goshawk22/wspr-balloon-tracker/hardware/v2/SCH_Schematic3_1-P1_2025-12-21.png

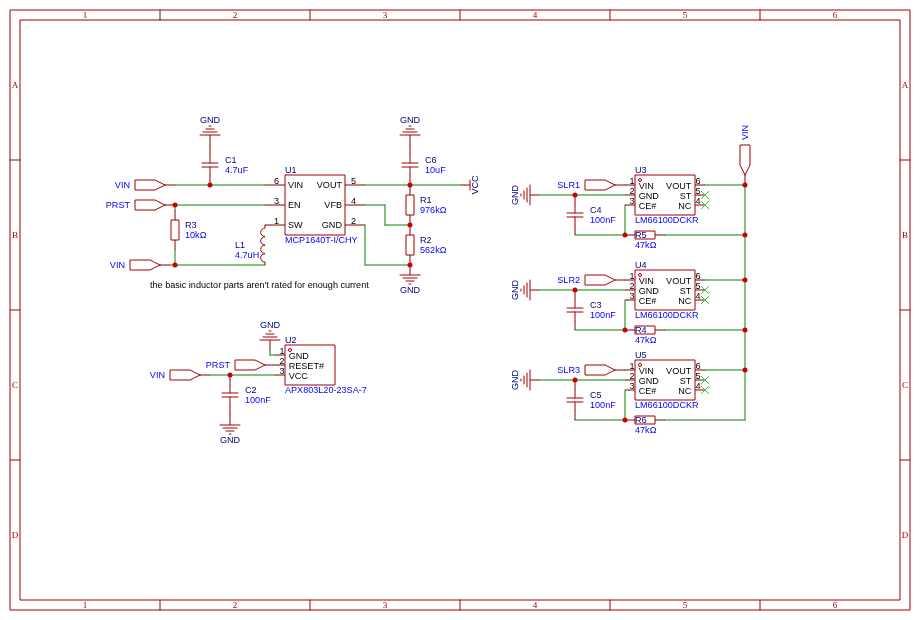
hardware/v2/SCH_Schematic3_1-P1_2025-12-21.png
