goshawk22/wspr-balloon-tracker/hardware/v2/SCH_Schematic3_2025-12-21.pdf

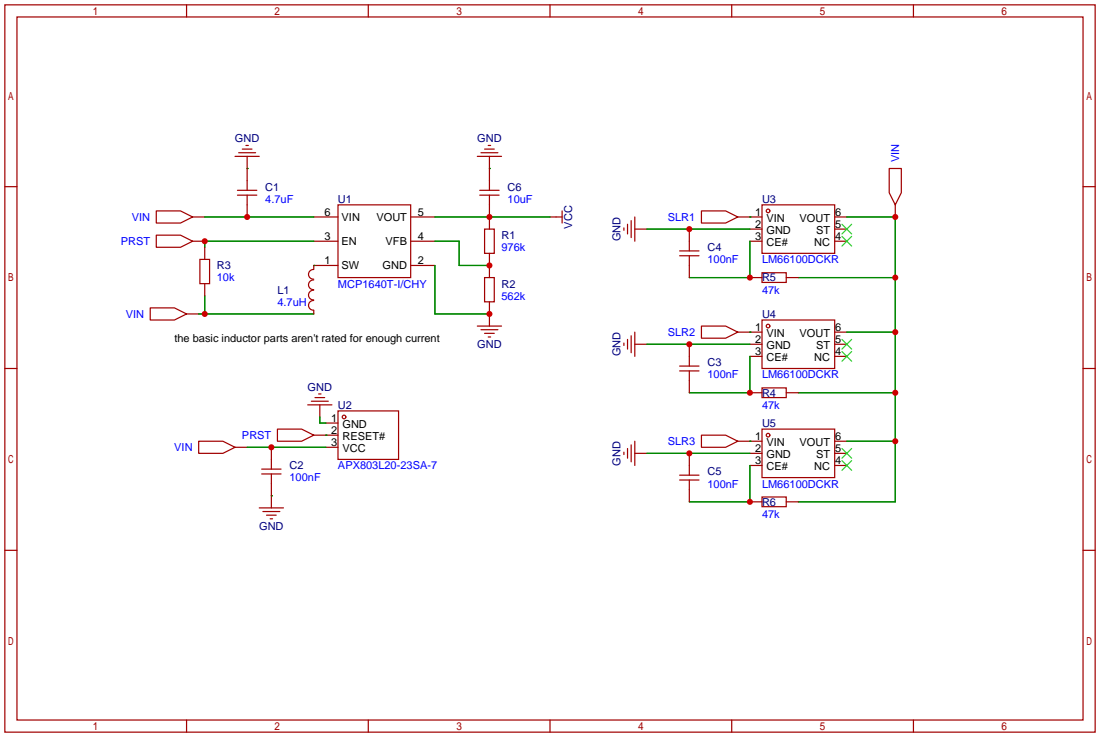
[picture p8: page 1]

the basic inductor parts aren't rated for enough current
