goshawk22/wspr-balloon-tracker/hardware/v2/SCH_Schematic1_2025-12-21.pdf

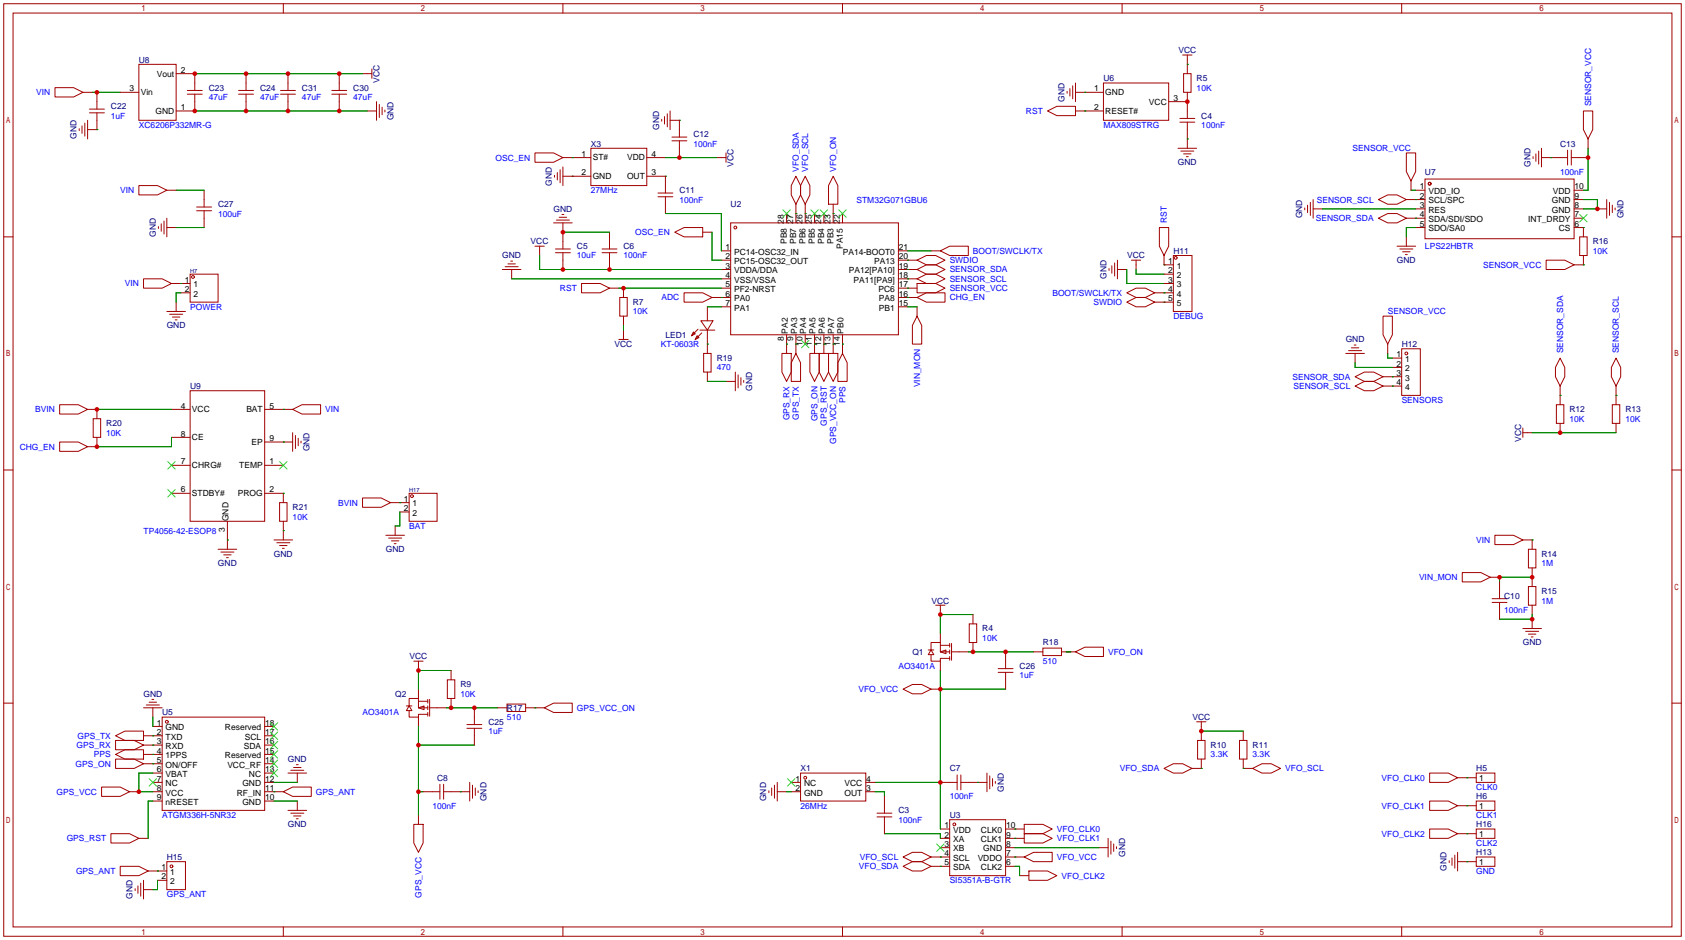
[picture p9: page 1]
