goshawk22/wspr-balloon-tracker/hardware/v1/SCH_Schematic1_2025-08-19.pdf

## VCCVIN

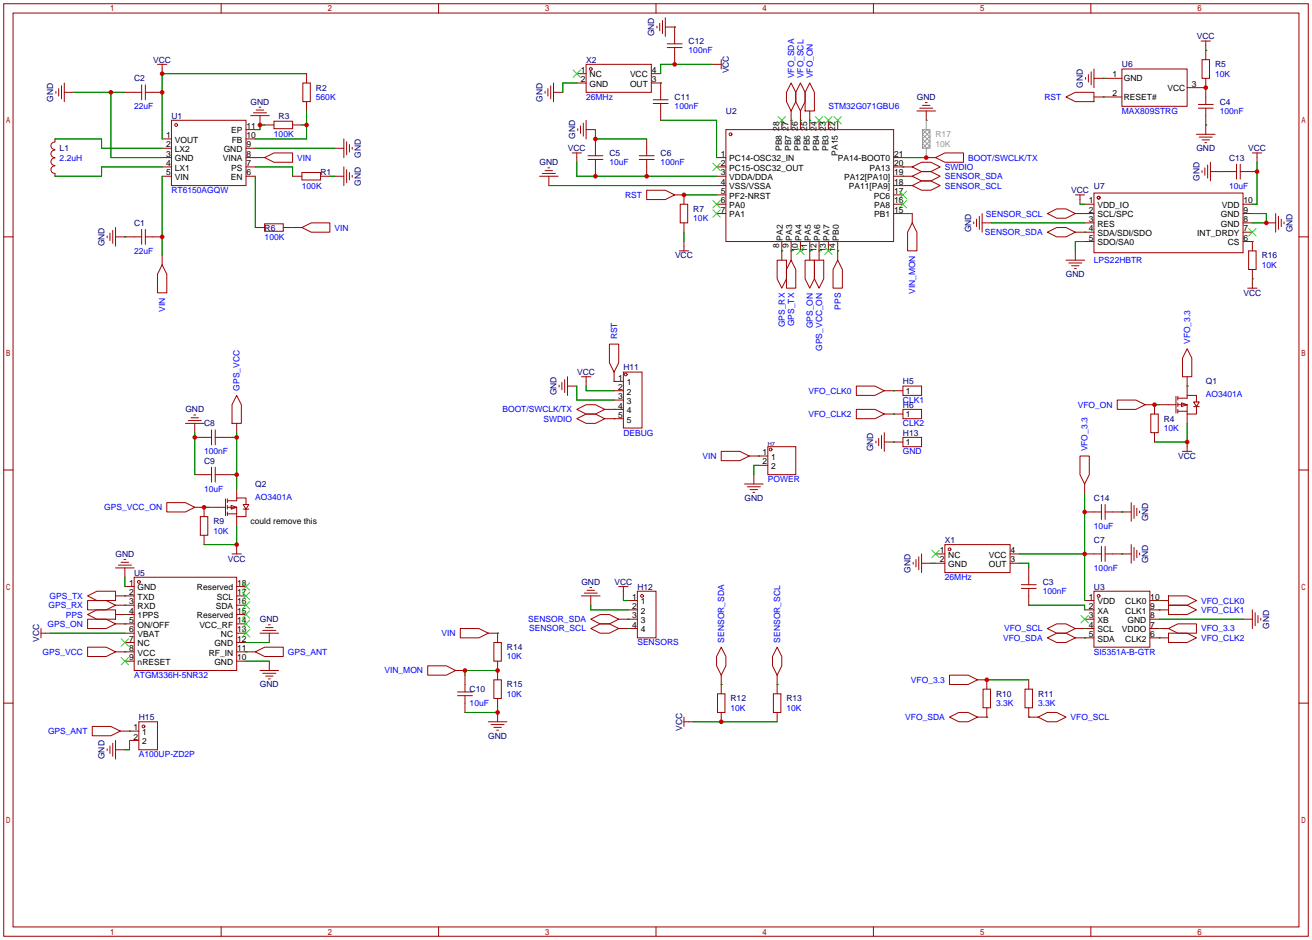
[picture p10: page 1]
