goshawk22/wspr-balloon-tracker/(list of files, drawings)

Other design files:
hardware/v1/ProPrj_picoballoon-tracker_2025-08-19.epro
hardware/v2/ProPrj_picoballoon-tracker-v2_2025-12-21.epro
