goshawk22/wspr-balloon-tracker/src/sensors.h

#ifndef SENSORS_H
#define SENSORS_H

#include "config.h"
#include "console.h"
#include "stm32yyxx_ll_adc.h"
#include "Arduino.h"
#include <Wire.h>
#include <Adafruit_LPS2X.h>
#include <Adafruit_Sensor.h>

class Sensors
{
public:
    Sensors();
    void begin();
    void update();
    void setSensorVCC(bool enabled);

    // Accessors
    float getVoltage() const
    {
        return voltage;
    }
    float getIntTemperature() const
    {
        return int_temperature;
    }
    float getTemperature() const
    {
        return temperature;
    }
    float getPressure() const
    {
        return pressure;
    }

private:
    float voltage; // Voltage read from ADC
    float int_temperature; // Temperature read from internal sensor
    float temperature; // Temperature read from LPS22 sensor
    float pressure; // Pressure read from LPS22 sensor

    static constexpr uint32_t TS_CAL1_ADDR = 0x1FFF75A8; // Temp calibration @ 30°C
    static constexpr uint32_t TS_CAL2_ADDR = 0x1FFF75CA; // Temp calibration @ 130°C
    static constexpr float TEMP30_CAL_TEMP = 30.0f;
    static constexpr float TEMP130_CAL_TEMP = 130.0f;

    static uint32_t readVref();
    static int32_t readVoltage(int32_t VRef, uint32_t pin);
};

#endif
