goshawk22/wspr-balloon-tracker/variants/pico_tracker/variant_PICO_TRACKER.cpp

/*
 *******************************************************************************
 * Copyright (c) 2020, STMicroelectronics
 * All rights reserved.
 *
 * This software component is licensed by ST under BSD 3-Clause license,
 * the "License"; You may not use this file except in compliance with the
 * License. You may obtain a copy of the License at:
 *                        opensource.org/licenses/BSD-3-Clause
 *
 *******************************************************************************
 */
#if defined(ARDUINO_PICO_TRACKER)
#include "pins_arduino.h"

// Digital PinName array
const PinName digitalPin[] = {
  PA_0,   // D0/A0
  PA_1,   // D1/A1
  PA_2,   // D2/A2
  PA_3,   // D3/A3
  PA_4,   // D4/A4
  PA_5,   // D5/A5
  PA_6,   // D6/A6
  PA_7,   // D7/A7
  PA_8,   // D8
  PA_11,  // D9
  PA_12,  // D10
  PA_13,  // D11
  PA_14,  // D12
  PA_15,  // D13
  PB_0,   // D14/A8
  PB_1,   // D15/A9
  PB_3,   // D16
  PB_4,   // D17
  PB_5,   // D18
  PB_6,   // D19
  PB_7,   // D20
  PB_8,   // D21
  PC_6,   // D22
  PC_14,  // D23
  PC_15,  // D24
  PF_2,   // D25
  PA_9_R, // D26
  PA_10_R // D27
};

// Analog (Ax) pin number array
const uint32_t analogInputPin[] = {
  0,  // A0,  PA0
  1,  // A1,  PA1
  2,  // A2,  PA2
  3,  // A3,  PA3
  4,  // A4,  PA4
  5,  // A5,  PA5
  6,  // A6,  PA6
  7,  // A7,  PA7
  14, // A8,  PB0
  15  // A9,  PB1
};

// ----------------------------------------------------------------------------
#ifdef __cplusplus
extern "C" {
#endif

/**
  * @brief  System Clock Configuration
  * @param  None
  * @retval None
  */
 // for LPUART, clock must be in the range [3x baud rate..4096 x baud rate], so max clock is 9600 * 4096 = 39321600
 // currently we use 18 MHz
void SystemClock_Config(void)
{
  RCC_OscInitTypeDef RCC_OscInitStruct = {0};
  RCC_ClkInitTypeDef RCC_ClkInitStruct = {0};

  /** Configure the main internal regulator output voltage
  */
  HAL_PWREx_ControlVoltageScaling(PWR_REGULATOR_VOLTAGE_SCALE1);

  /** Initializes the RCC Oscillators according to the specified parameters
  * in the RCC_OscInitTypeDef structure.
  */
  RCC_OscInitStruct.OscillatorType = RCC_OSCILLATORTYPE_HSE;
  RCC_OscInitStruct.HSEState = RCC_HSE_BYPASS;
  RCC_OscInitStruct.HSIDiv = RCC_HSI_DIV1;
  RCC_OscInitStruct.HSICalibrationValue = RCC_HSICALIBRATION_DEFAULT;
  RCC_OscInitStruct.PLL.PLLState = RCC_PLL_ON;
  RCC_OscInitStruct.PLL.PLLSource = RCC_PLLSOURCE_HSE;
  RCC_OscInitStruct.PLL.PLLM = RCC_PLLM_DIV2;
  RCC_OscInitStruct.PLL.PLLN = 8;
  RCC_OscInitStruct.PLL.PLLP = RCC_PLLP_DIV2;
  RCC_OscInitStruct.PLL.PLLQ = RCC_PLLQ_DIV2;
  RCC_OscInitStruct.PLL.PLLR = RCC_PLLR_DIV6;
  if (HAL_RCC_OscConfig(&RCC_OscInitStruct) != HAL_OK)
  {
    Error_Handler();
  }

  /** Initializes the CPU, AHB and APB buses clocks
  */
  RCC_ClkInitStruct.ClockType = RCC_CLOCKTYPE_HCLK|RCC_CLOCKTYPE_SYSCLK
                              |RCC_CLOCKTYPE_PCLK1;
  RCC_ClkInitStruct.SYSCLKSource = RCC_SYSCLKSOURCE_PLLCLK;
  RCC_ClkInitStruct.AHBCLKDivider = RCC_SYSCLK_DIV1;
  RCC_ClkInitStruct.APB1CLKDivider = RCC_HCLK_DIV1;

  if (HAL_RCC_ClockConfig(&RCC_ClkInitStruct, FLASH_LATENCY_0) != HAL_OK)
  {
    Error_Handler();
  }
  // Update SystemCoreClock global variable
  SystemCoreClockUpdate();
}

#ifdef __cplusplus
}
#endif
#endif /* ARDUINO_PICO_TRACKER */
