goshawk22/wspr-balloon-tracker/src/telemetry.h

#ifndef TELEMETRY_H
#define TELEMETRY_H

#include <WsprEncoded.h>
#include <si5351.h>
#include <JTEncode.h>
#include <rs_common.h>
#include <int.h>
#include <string.h>
#include <Wire.h>
#include "config.h"
#include "console.h"
#include "led.h"

class Telemetry
{
public:
    Telemetry(Si5351 &si5351);
    void init();
    void sendType1(char call[], char loc[], uint8_t dbm);
    void sendBasic(char loc[], int32_t altitudeMeters, int8_t temperatureCelsius, double voltageVolts, uint8_t speedKnots);
    void sendExtended(char loc[], uint8_t satellites, uint32_t fix_time);
    void sendSlot1_new(char loc[], double voltageVolts);
    void sendSlot2_new(int32_t altitudeMeters, uint8_t speedKPH, int8_t temperatureCelsius, uint8_t satellites);
    uint32_t getFrequency() const
    {
        return cd.freq;
    }
    uint8_t getMinute() const
    {
        return cd.min;
    }
    bool isTransmitting() const {
        return transmitting;
    }
    bool isExtendedSent() const {
        return sentExtended;
    }
    void setExtendedSent(bool value) {
        sentExtended = value;
    }
private:
    void tx(unsigned long freq);
    void set_tx_buffer(const char* call, const char* loc, uint8_t dbm);
    Si5351 si5351;
    JTEncode jtencode;
    uint8_t tx_buffer[255];
    WsprChannelMap::ChannelDetails cd;

    HardwareTimer *timer;
    volatile bool transmitting;
    volatile uint8_t current_symbol;
    volatile unsigned long base_freq;

    bool sentExtended = false; // Flag to indicate if extended telemetry has been sent

    // Timer callback function (must be static)
    static void timerCallback();
    static Telemetry* instance; // For callback access
};

#endif
