goshawk22/wspr-balloon-tracker/(commit log)

2025-07-26 Initial commit Kind of works, transmits Type 1 messages followed by basic telemetry TODO: - Check temperature sensor - Check GPS speed/sats not reporting correctly - Check VIN_MON and that it works f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
    [config.h, console.h, generic_clock.c, gps.cpp, gps.h, main.cpp]
2025-07-27 Fix adc for temp and vin voltage
    [config.h, sensors.cpp]
2025-07-27 Only update sensors before sending and turn GPS off while sending
    Ensures we don't use too much current while transmitting
    [main.cpp]
2025-07-27 Use USART1 for pc serial
    SS just wasn't working and causing all sorts of issues.
    Annoying since we now have to use USART1 on the sensor I2C bus and obviously can't use both at the same time.
    Will have to see if we can get LPUART1 working for GPS.
    [console.h, main.cpp]
2025-07-27 Use hardware timer for WSPR
    Now we're ready to add watchdog.
2025-07-27 Fix LPUART
    Turns out our clock speed was too high
    Drop it to 18MHz, which should be plenty and save some power too.
    Now we can use sensors again!
    [config.h, console.h, gps.cpp, main.cpp, variant_PICO_TRACKER.cpp]
2025-07-30 Add extended telemetry
    Currently we transmit pressure, 8 figure maidenhead grid, uptime and sats
2025-07-30 Pass 6 figure grid to JTEncode
    Doesn't support 8 figure
    [telemetry.cpp]
2025-07-30 Add watchdog timer
    Didn't crash without it while running for about 8h or so before adding the watchdog so it's probably stable.
    Add the watchdog in case something weird happens.
    16s is just a random number I cam up with
    [main.cpp]
2025-07-30 Configure PPS pin
2025-08-07 Improve power on in low power conditions
    Maiden flight failed to wake up the following morning
    Testing overnight on the ground revealed that it entered a reset loop, where the MCU would crash after powering on the SI5351, likely due to inrush current. The MCU was the reset by the watchdog, so at least we know that works.
    The situation was not improved with a supercap. Current theory is that the board tries to power on as soon as it gets any power, but at this point the panels can't supply enough current. When it tries to pull more current, the panel voltage collapses causing the board to reset.
    This commit makes the MCU test the supercap/solar voltage. If it's above a certain threshold whe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
    [gps.cpp, main.cpp, sensors.cpp, sensors.h, telemetry.cpp]
2025-08-19 Add readme and hardware info
    [ProPrj_picoballoon-tracker_2025-08-19.epro]
2025-12-18 Changes for new tracker
    Updated pin definitions
    New LED class for debugging/checking tracker on launch day
    Improve GPS handling and add time to first fix
    Add 10 figure maidenhead support with format AA00BB1122
    Reorganise main logic and remove voltage checks as bug is now fixed in hardware
    Don't include support for pressure sensor if it's not on the board
    Use new extended telemetry, with support for 10 char maidenhead
    Add WIP replacement for basic telemetry
    Add test script for maidenhead functionality
    Disable HSI as we can exclusively use HSE
    [config.h, gps.cpp, gps.h, led.cpp, led.h, main.cpp, sensors.cpp, sensors.h]
2025-12-18 Fix ADC definitions
    We have two pins, one internally routed to VIN and the other exposed as a pad.
    The VIN adc can only be used when the panels are connected directly to the board and not via a secondary power board.
    [config.h, sensors.cpp]
2025-12-21 Add v2 hardware info
    [ProPrj_picoballoon-tracker-v2_2025-12-21.epro, ProPrj_picoballoon-tracker_2025-08-19.epro]
